BirkanG/Temp_Initiated_Object_Detection/README.md

# EE447 Term Project Temperature-Initiated Object Detection

[Project Definition](ee447_Term_Project_2024_25.pdf)

[Final Report](ee447_term_project_report.pdf)

[Demo Video](https://www.youtube.com/watch?v=qJ5J-r5qGlc)
