BirkanG/Temp_Initiated_Object_Detection/project_447/Nokia5110TestMain.c

// Nokia5110TestMain.c
// Runs on LM4F120/TM4C123
// Test the functions in Nokia5110.c by printing various
// things to the LCD.
// Daniel Valvano
// September 16, 2013

// Font table, initialization, and other functions based
// off of Nokia_5110_Example from Spark Fun:
// 7-17-2011
// Spark Fun Electronics 2011
// Nathan Seidle
// http://dlnmh9ip6v2uc.cloudfront.net/datasheets/LCD/Monochrome/Nokia_5110_Example.pde

/* This example accompanies the book
   "Embedded Systems: Real Time Interfacing to Arm Cortex M Microcontrollers",
   ISBN: 978-1463590154, Jonathan Valvano, copyright (c) 2014

 Copyright 2014 by Jonathan W. Valvano, valvano@mail.utexas.edu
    You may use, edit, run or distribute this file
    as long as the above copyright notice remains
 THIS SOFTWARE IS PROVIDED "AS IS".  NO WARRANTIES, WHETHER EXPRESS, IMPLIED
 OR STATUTORY, INCLUDING, BUT NOT LIMITED TO, IMPLIED WARRANTIES OF
 MERCHANTABILITY AND FITNESS FOR A PARTICULAR PURPOSE APPLY TO THIS SOFTWARE.
 VALVANO SHALL NOT, IN ANY CIRCUMSTANCES, BE LIABLE FOR SPECIAL, INCIDENTAL,
 OR CONSEQUENTIAL DAMAGES, FOR ANY REASON WHATSOEVER.
 For more information about my classes, my research, and my books, see
 http://users.ece.utexas.edu/~valvano/
 */

// Blue Nokia 5110
// ---------------
// Signal        (Nokia 5110) LaunchPad pin
// Reset         (RST, pin 1) connected to PA7
// SSI0Fss       (CE,  pin 2) connected to PA3
// Data/Command  (DC,  pin 3) connected to PA6
// SSI0Tx        (Din, pin 4) connected to PA5
// SSI0Clk       (Clk, pin 5) connected to PA2
// 3.3V          (Vcc, pin 6) power
// back light    (BL,  pin 7) not connected
// Ground        (Gnd, pin 8) ground

// Red SparkFun Nokia 5110 (LCD-10168)
// -----------------------------------
// Signal        (Nokia 5110) LaunchPad pin
// 3.3V          (VCC, pin 1) power
// Ground        (GND, pin 2) ground
// SSI0Fss       (SCE, pin 3) connected to PA3
// Reset         (RST, pin 4) connected to PA7
// Data/Command  (D/C, pin 5) connected to PA6
// SSI0Tx        (DN,  pin 6) connected to PA5
// SSI0Clk       (SCLK, pin 7) connected to PA2
// back light    (LED, pin 8) not connected

#include <stdint.h>
#include "Nokia5110.h"
//#include "PLL.h"

// delay function for testing from sysctl.c
// which delays 3*ulCount cycles
// Declare the delay function implemented in assembly
extern void a_delay(uint32_t ulCount);


// image of a longhorn
const uint8_t Longhorn[] = {
  0x08, 0x08, 0x08, 0x08, 0x08, 0x18, 0x18, 0x18, 0x38, 0x30, 0x30, 0x30, 0x70, 0xF0,
  0xE0, 0xC0, 0xC0, 0x80, 0x00, 0x00, 0x00, 0x00, 0x00, 0x00, 0x00, 0x00, 0x00, 0x00,
  0x00, 0x00, 0x00, 0x00, 0x00, 0x00, 0x00, 0x00, 0x00, 0x00, 0x00, 0x00, 0x00, 0x00,
  0x00, 0x00, 0x00, 0x00, 0x00, 0x00, 0x00, 0x00, 0x00, 0x00, 0x00, 0x00, 0x00, 0x00,
  0x00, 0x00, 0x00, 0x00, 0x00, 0x00, 0x00, 0x80, 0xC0, 0xC0, 0xE0, 0xE0, 0xF0, 0x70,
  0x70, 0x30, 0x30, 0x18, 0x18, 0x18, 0x18, 0x08, 0x08, 0x08, 0x08, 0x00, 0x00, 0x00,
  0x00, 0x00, 0x00, 0x00, 0x00, 0x00, 0x00, 0x00, 0x00, 0x00, 0x00, 0x00, 0x00, 0x00,
  0x01, 0x03, 0x03, 0x03, 0x07, 0x0F, 0x0E, 0x0C, 0x1C, 0x38, 0x38, 0xB8, 0xF8, 0xF0,
  0xF0, 0xF8, 0xF8, 0xF8, 0xF8, 0xF8, 0xF8, 0xFC, 0xFC, 0xF8, 0xF8, 0xF8, 0xF8, 0xF8,
  0xF8, 0xF8, 0xF8, 0xF8, 0xF8, 0xF8, 0xF8, 0xF8, 0xF0, 0xE0, 0xE0, 0xF0, 0xF0, 0xF0,
  0xF0, 0x78, 0x38, 0x3C, 0x1C, 0x1F, 0x0F, 0x07, 0x03, 0x03, 0x01, 0x00, 0x00, 0x00,
  0x00, 0x00, 0x00, 0x00, 0x00, 0x00, 0x00, 0x00, 0x00, 0x00, 0x00, 0x00, 0x00, 0x00,
  0x00, 0x00, 0x00, 0x00, 0x00, 0x00, 0x00, 0x00, 0x00, 0x00, 0x00, 0x00, 0x00, 0x00,
  0x00, 0x00, 0x00, 0x00, 0x00, 0x00, 0x00, 0x00, 0x00, 0x06, 0x0F, 0x0F, 0x0F, 0x0F,
  0x0F, 0x07, 0x07, 0x07, 0x1F, 0xFF, 0xFF, 0xFF, 0xFF, 0xFF, 0xFF, 0xFF, 0xFF, 0xFF,
  0xFF, 0xFF, 0xFF, 0xFF, 0xFF, 0xFF, 0xFF, 0xFF, 0x1F, 0x0F, 0x1F, 0x1F, 0x1F, 0x1F,
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
  0x00, 0x00, 0x00, 0x00, 0x00, 0x00, 0x00, 0x00, 0x00, 0x00, 0x00, 0x00, 0x00, 0x00,
  0x00, 0x00, 0x00, 0x00, 0x00, 0x00, 0x00, 0x00, 0x00, 0x00, 0x00, 0x00, 0x00, 0x00,
  0x00, 0x00, 0x00, 0x00, 0x00, 0x00, 0x00, 0x00, 0x00, 0x00, 0x00, 0x00, 0x00, 0x00,
  0x00, 0x00, 0x00, 0x00, 0x00, 0x00, 0x00, 0x00, 0x00, 0x00, 0x00, 0x00, 0x00, 0x00,
  0x00, 0x00, 0x00, 0x00, 0x00, 0x00, 0x00, 0x00, 0x00, 0x00, 0x00, 0x00, 0x00, 0x00,
  0x00, 0x00, 0x00, 0x00, 0x00, 0x00, 0x00, 0x00, 0x00, 0x00, 0x00, 0x00, 0x00, 0x00,
  0x00, 0x00, 0x00, 0x00, 0x00, 0x00, 0x00, 0x00, 0x00, 0x00, 0x00, 0x00, 0x00, 0x00
};


int main(void){
  uint32_t count = 0;
  //PLL_Init();                           // set system clock to 50 MHz
  Nokia5110_Init();
//  for(count=0; count<5; count=count+1){
//    Nokia5110_DrawFullImage(Longhorn);
//    a_delay(16666667);                    // delay ~1 sec at 50 MHz
//    Nokia5110_DrawFullImage(Longhorn2);
//    a_delay(16666667);                    // delay ~1 sec at 50 MHz
//  }
  count = 0;
  Nokia5110_Clear();
  Nokia5110_OutString("************* LCD Test *************");
	Nokia5110_OutString("Letter: Num:------- ---- ");
  Nokia5110_OutChar(127);               // print UT sign
  while(1){
    Nokia5110_SetCursor(5, 5);          // five leading spaces, bottom row
    Nokia5110_OutChar((count%26)+'A');
		Nokia5110_OutChar('L');
    Nokia5110_OutUDec(count);
    a_delay(5333333);                     // delay ~0.5 sec at 50 MHz
    count = count + 1;
  }
}
